geekhostuk/racetimer/cad/seeed-esp32-antenna-case.3mf

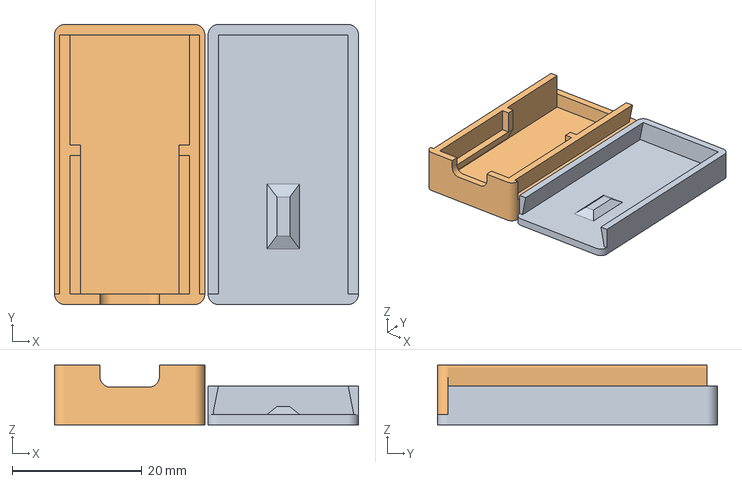
[picture p1: CAD file, 2026-10-25]
cad/seeed-esp32-antenna-case.3mf
46.9 x 43.2 x 9.20 mm
