geekhostuk/racetimer/(commit log)

2026-10-23 racetimer: two-receiver gate validation on Widscan58
    Two Widscan58 receivers (ESP32-C5, top and bottom bar) per gate on UARTs to
    an ESP32-WROOM gate controller, which runs Widscan58's lap.c per receiver
    and channel, pairs the top and bottom passes and calls each one VALID,
    OVER, UNDER or single-board, and serves a live web UI from its own access
    point. Widscan58 is a submodule (fork geekhostuk/widscan58, branch
    uart-link, which adds the UART host link).
    - gate/: WROOM firmware (ESP-IDF via PlatformIO), fusion host tests
    - tools/: UI simulator, C5 UART frame reader, recording plotter
    - docs/hardware.md: wiring, antennas, gain
2026-10-23 gate: baud diagnostic command; don't let a stalled client block the server
    - 'baud <board> <rate>' listens to a receiver at another speed, e.g.
    115200 to read its boot ROM messages (reset reasons). No setups while
    it is off the link speed.
    - A WebSocket send blocks the HTTP server task until the client takes
    it; a client that stopped reading stalled the whole server for seconds
    per message. Sends now time out after 1 s and close that client, and
    at most 24 sends are queued.
    [c5_link.c, c5_link.h, web.c, web.h]
2026-10-23 docs: parts list; power the receivers from the supply, not the WROOM
    parts.md lists what a gate needs. hardware.md now has the 4-core cable
    wiring, the capacitor at each C5, and why VIN on a WROOM DevKit can't feed
    them: a C5 fed from it reset every ~200 ms with RTC_PWR_GLITCH, and ran
    fine from its own USB. Also the pin labels that caused confusion (VBUS on
    the XIAO; VIN that looks like VN on the WROOM), and how to check a
    receiver's power with the baud command.
2026-10-23 docs: build guide with plan, parts, wiring diagrams and gate placement
2026-10-25 gate: join the home network with retries, and show it on the page
    The station link now retries from 2 s, doubling to 60 s, instead of trying
    once at boot; a changed network or password is tried straight away. The
    page shows a Wi-Fi chip, the gate's address on the home network or why it
    didn't connect, and a Saved mark after Save. The station takes the access
    point's name as its hostname, so the router lists it.
    [web.c]
2026-10-25 README: a work in development, counting laps on the RaceGOW gates
    The receivers sit in opposite corners of each gate (a top corner and the
    bottom corner across from it), not centred on the bars; the build guide
    notes this above its original layout. Status now says the timers detect
    laps on the RaceGOW track, with antennas, placement and thresholds still
    being worked out. Adds the printable C5 antenna case.
2026-10-25 cad: printable case for the XIAO ESP32-C5 and its antenna
    [seeed-esp32-antenna-case.3mf]
